luminoucid/ThreadDripperV1/3d_printing/mount_left_frontPanal.stl

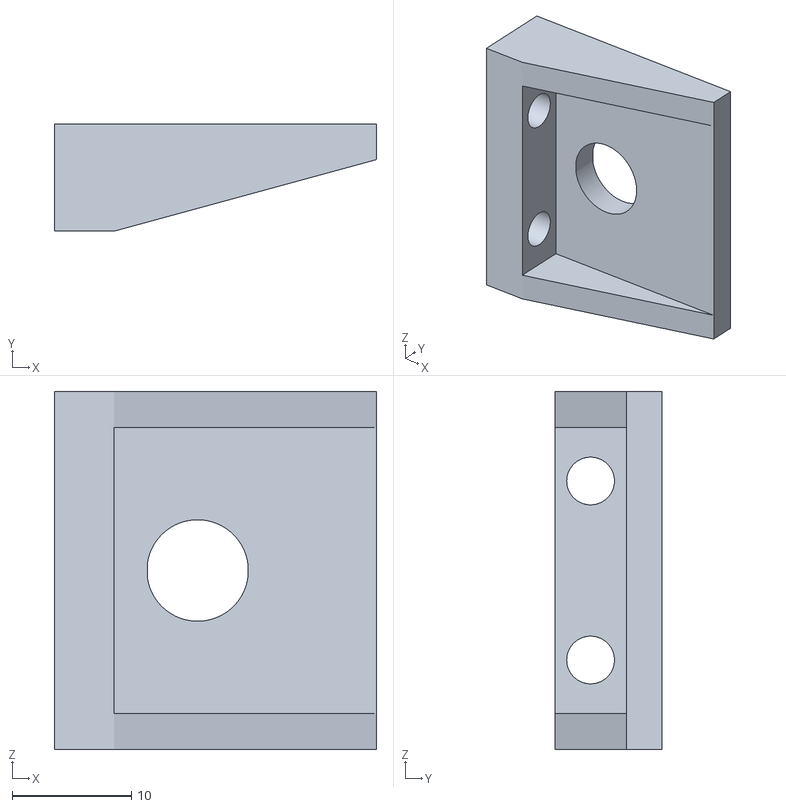
[picture p22: CAD file, 2025-05-22]
3d_printing/mount_left_frontPanal.stl
27.0 x 9.00 x 30.0
