luminoucid/ThreadDripperV1/3d_printing/solarPanel/solarPanel_mount_base.stl

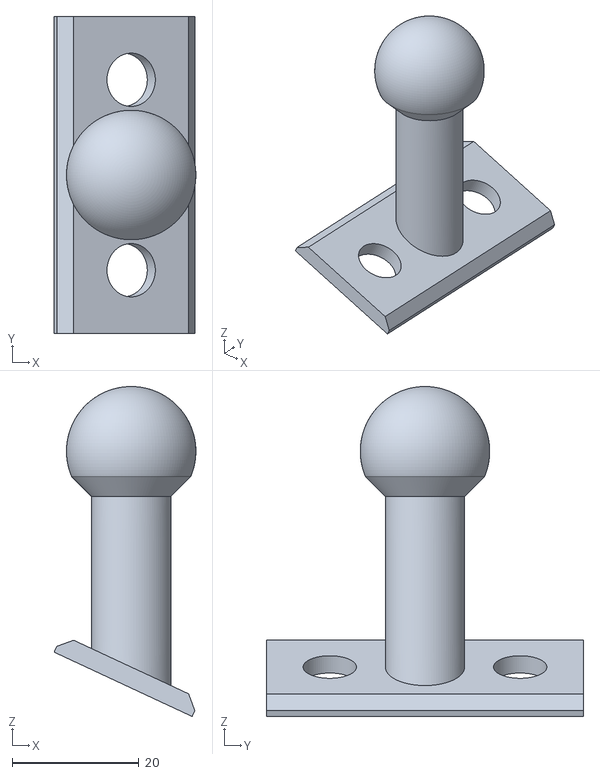
[picture p23: CAD file, 2025-05-22]
3d_printing/solarPanel/solarPanel_mount_base.stl
22.3 x 50.0 x 52.0
