luminoucid/ThreadDripperV1/3d_printing/solarPanel/solarPanel_mount_Connection.stl

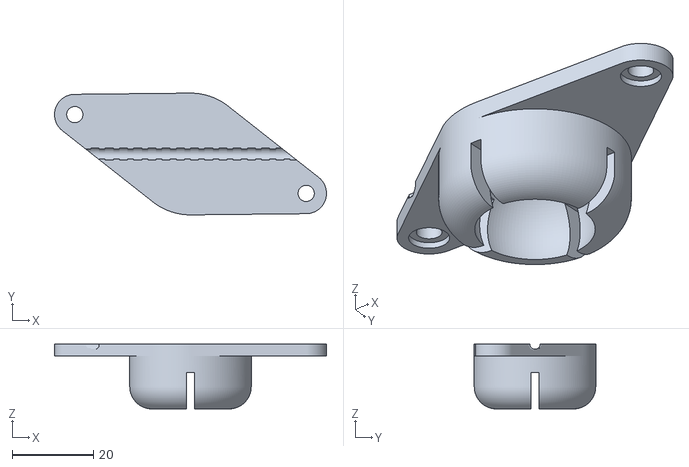
[picture p24: CAD file, 2025-05-22]
3d_printing/solarPanel/solarPanel_mount_Connection.stl
67.0 x 30.0 x 16.0
