luminoucid/ThreadDripperV1/3d_printing/mount_powerBank_motorDriver.stl

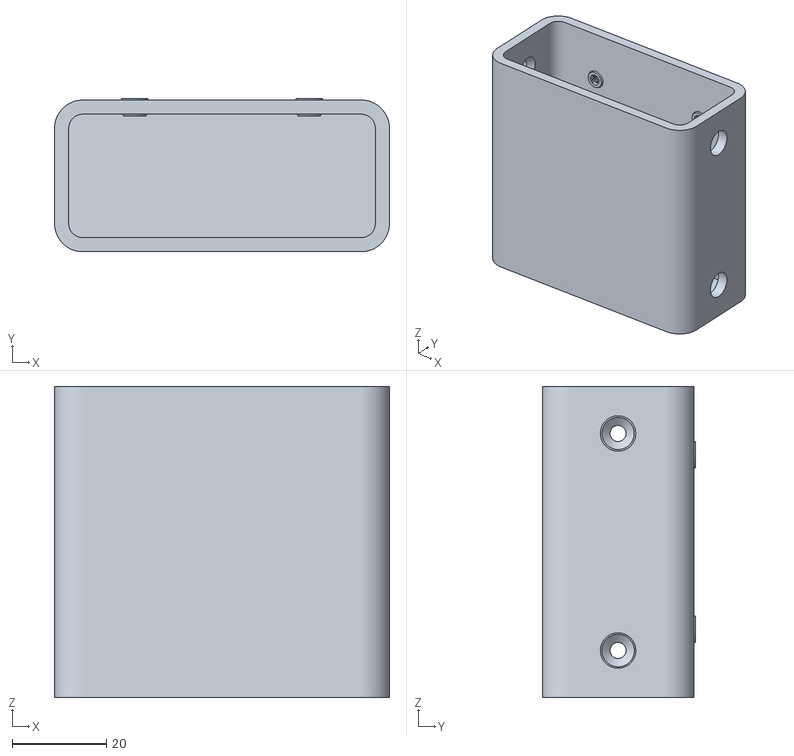
[picture p25: CAD file, 2025-05-22]
3d_printing/mount_powerBank_motorDriver.stl
71.0 x 32.5 x 66.0
