luminoucid/ThreadDripperV1/3d_printing/solarPanel/solarPanel_frame.stl

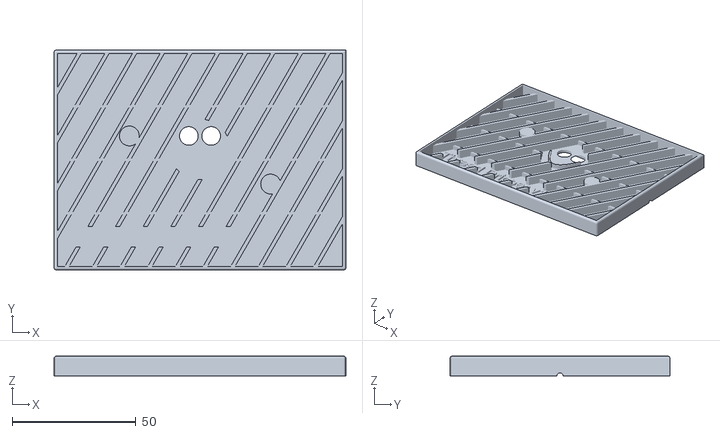
[picture p26: CAD file, 2025-05-22]
3d_printing/solarPanel/solarPanel_frame.stl
117.8 x 88.8 x 8.00
