luminoucid/ThreadDripperV1/(list of files, cad)

Other CAD files:
3d_printing/mount_right_frontPanal.stl
