luminoucid/ThreadDripperV1/frame/threadDripperFrameAssambly.pdf

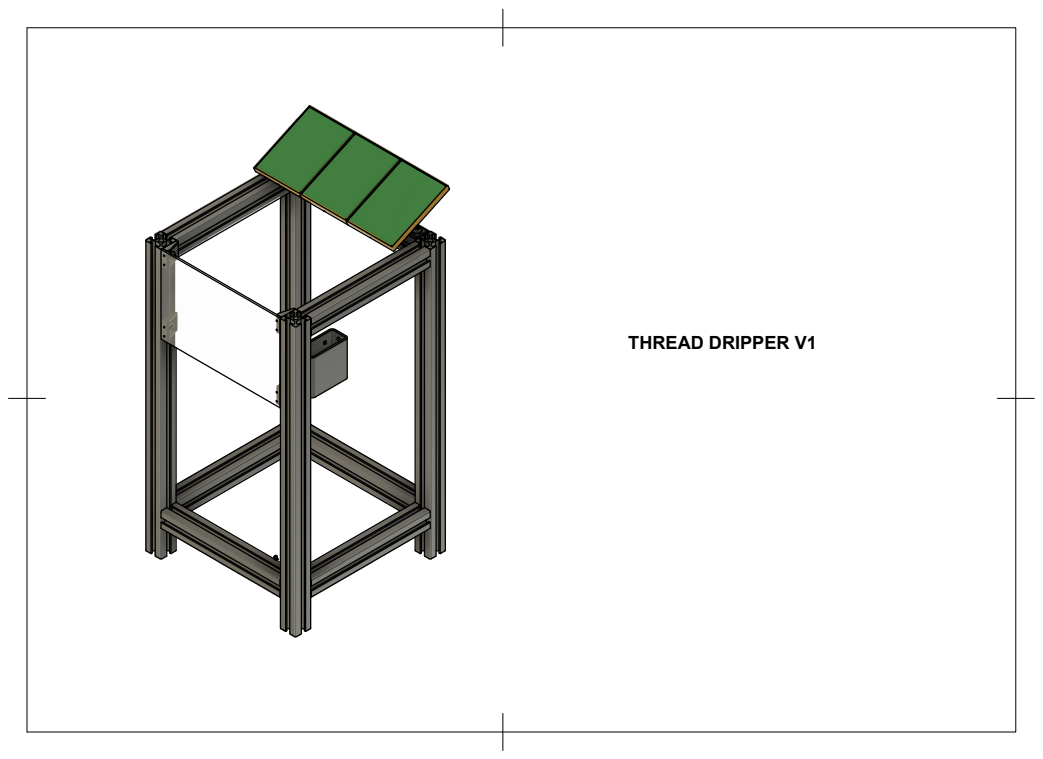
[picture p27: page 1]
THREAD DRIPPER V1

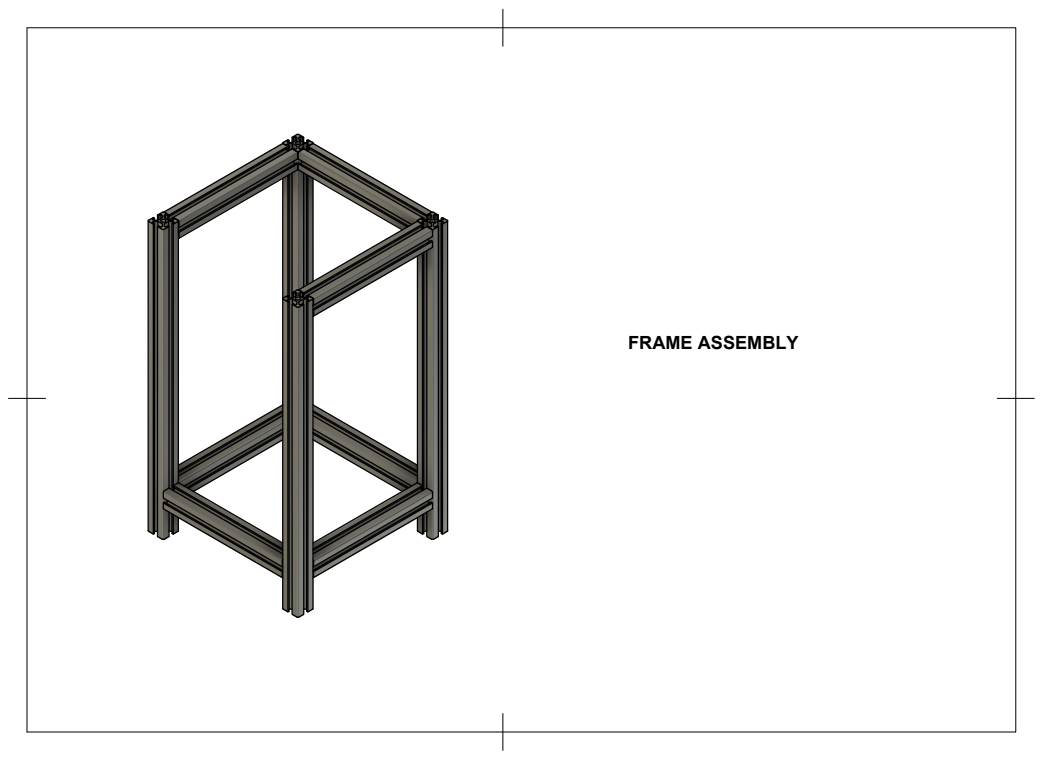
[picture p28: page 2]
FRAME ASSEMBLY

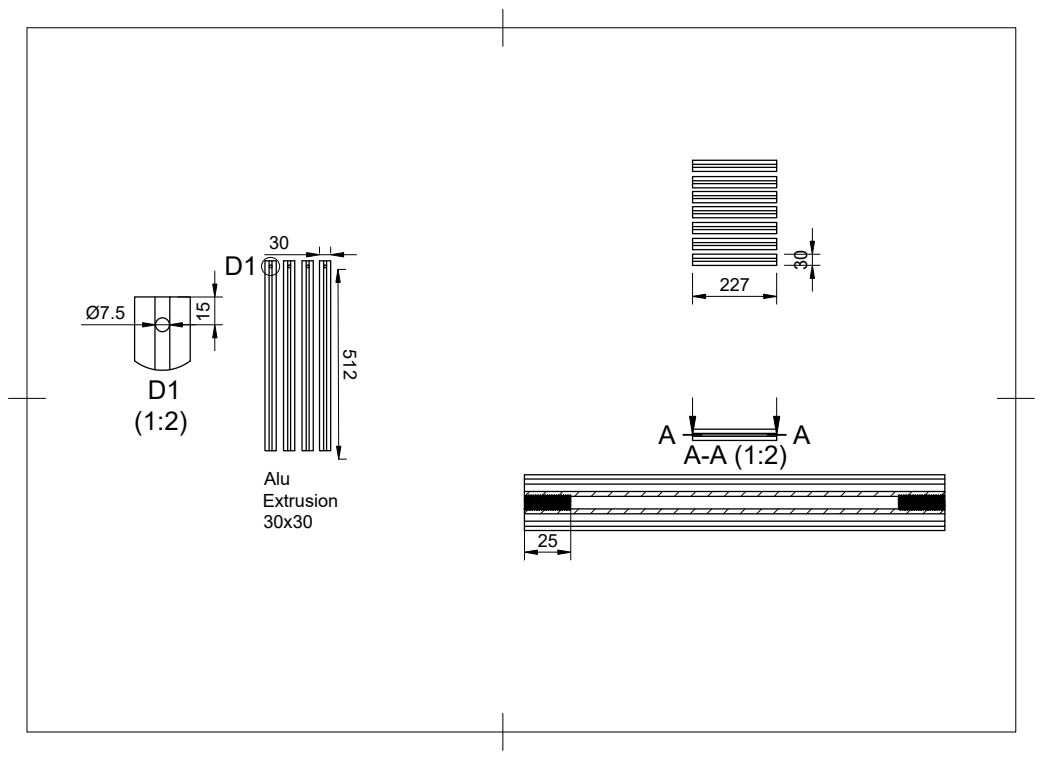
[picture p29: page 3]
Alu Extrusion 30x30

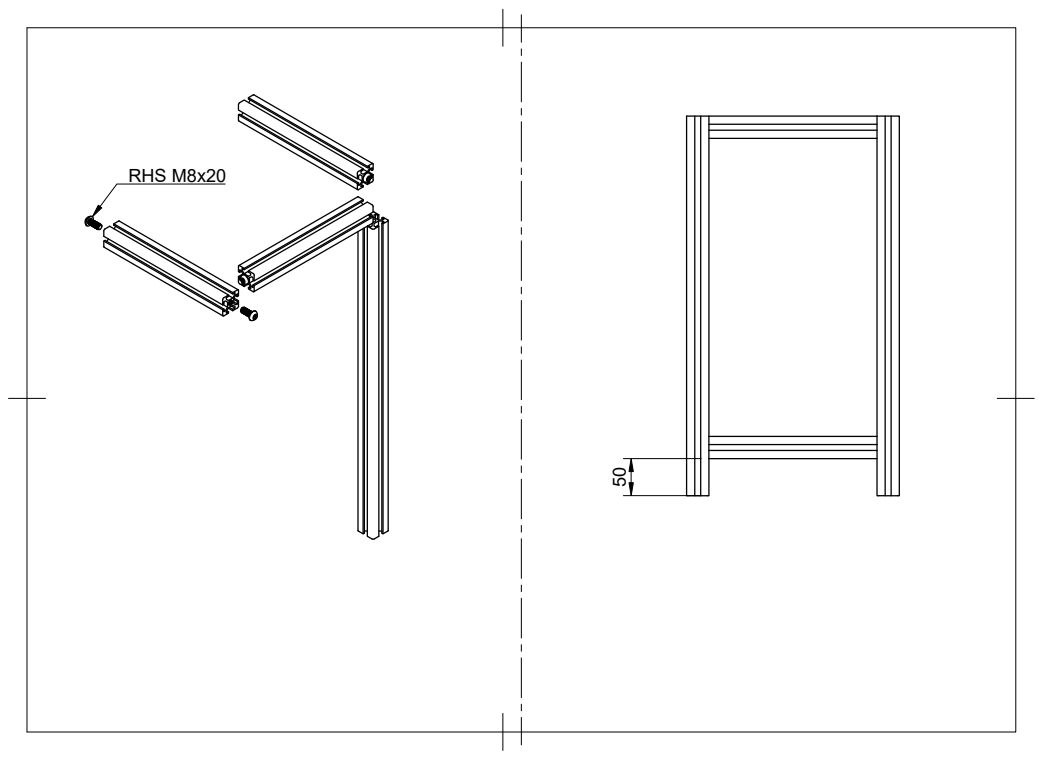
[picture p30: page 4]
RHS M8x20

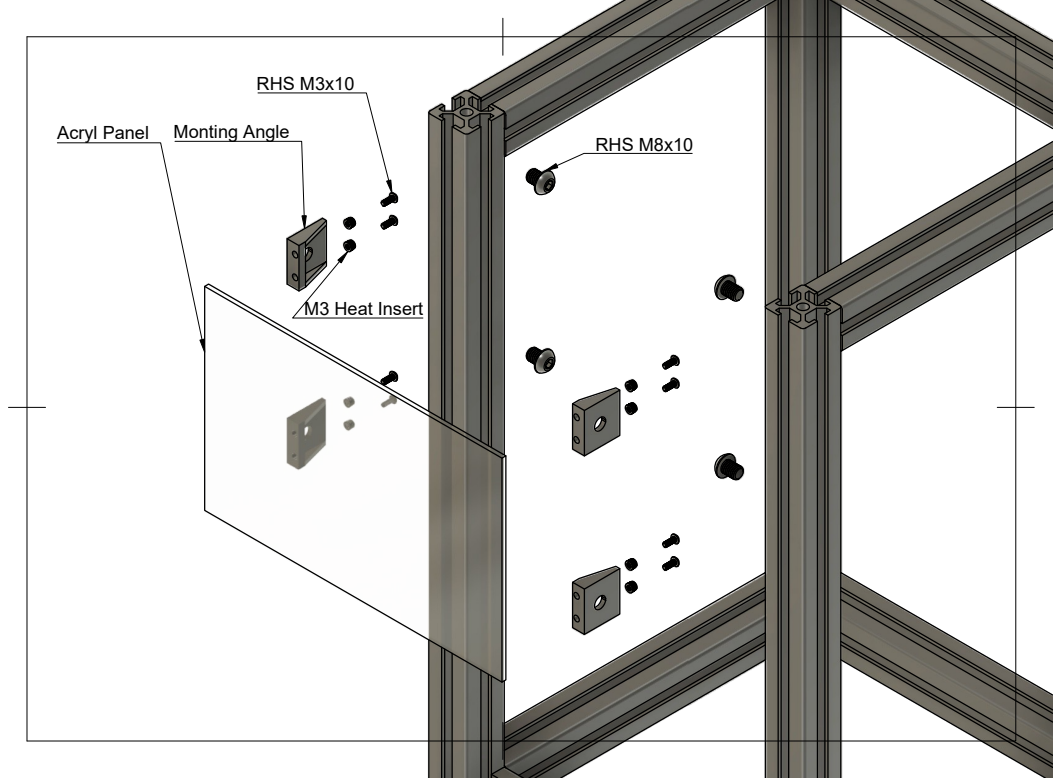
[picture p31: page 5]
Acryl Panel; Monting Angle; RHS M3x10; M3 Heat Insert; RHS M8x10

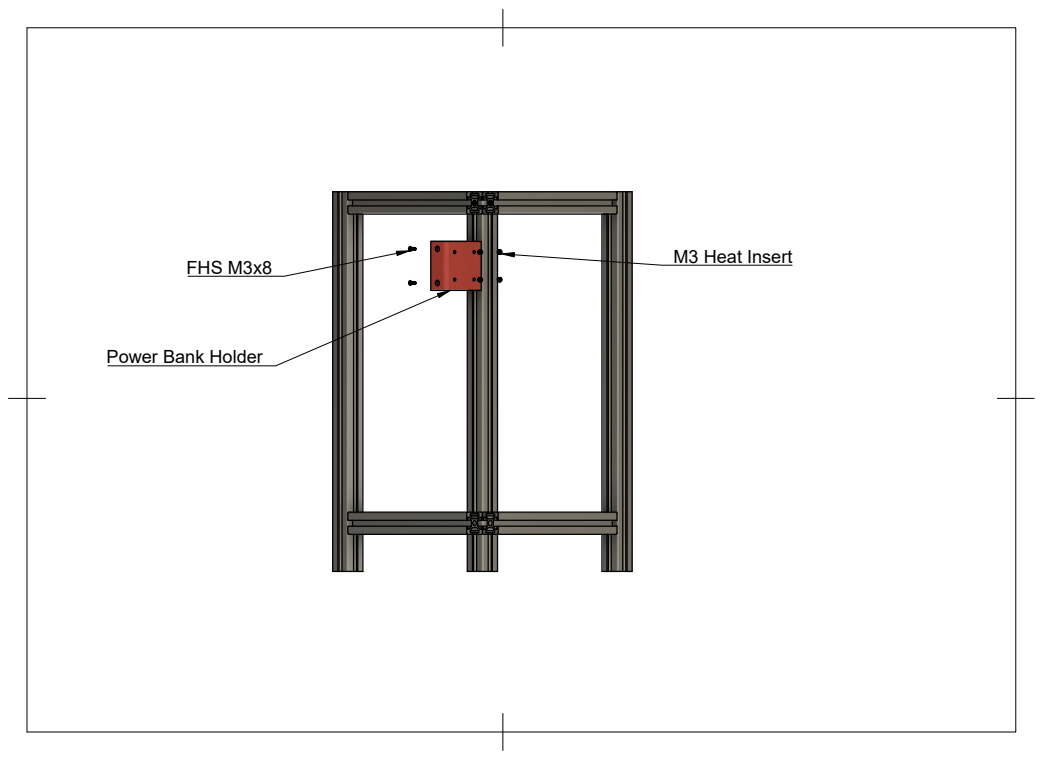
[picture p32: page 6]
FHS M3x8; M3 Heat Insert

Power Bank Holder

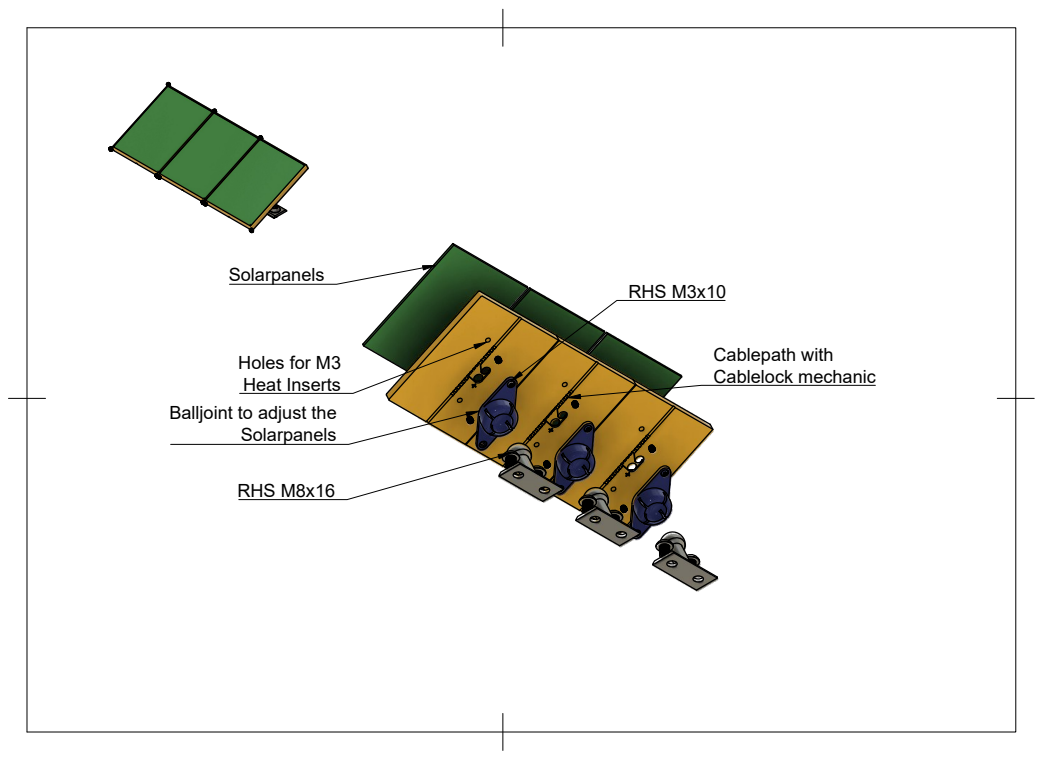
[picture p33: page 7]
Holes for M3 Heat Inserts; Solarpanels; RHS M3x10; Cablepath with Cablelock mechanic; RHS M8x16

Balljoint to adjust the
