luminoucid/ThreadDripperV1/(list of files, drawings)

Other design files:
fritzing/ThreadDripperV1.fzz
